DeMarco/DMH-Dual-VCF-Diode-Ladder/README.md

# DMH-Dual-VCF-Diode-Ladder
Stereo version of DMH Diode Ladder VCF
