DeMarco/DMH-Dual-VCF-Diode-Ladder/DMH_Dual_VCF_Diode_Ladder_PCB/DMH_Dual_VCF_Diode_Ladder_PCB.kicad_pcb

## KiCad design DMH_Dual_VCF_Diode_Ladder_PCB/DMH_Dual_VCF_Diode_Ladder_PCB.kicad_pcb (2025-01-10)

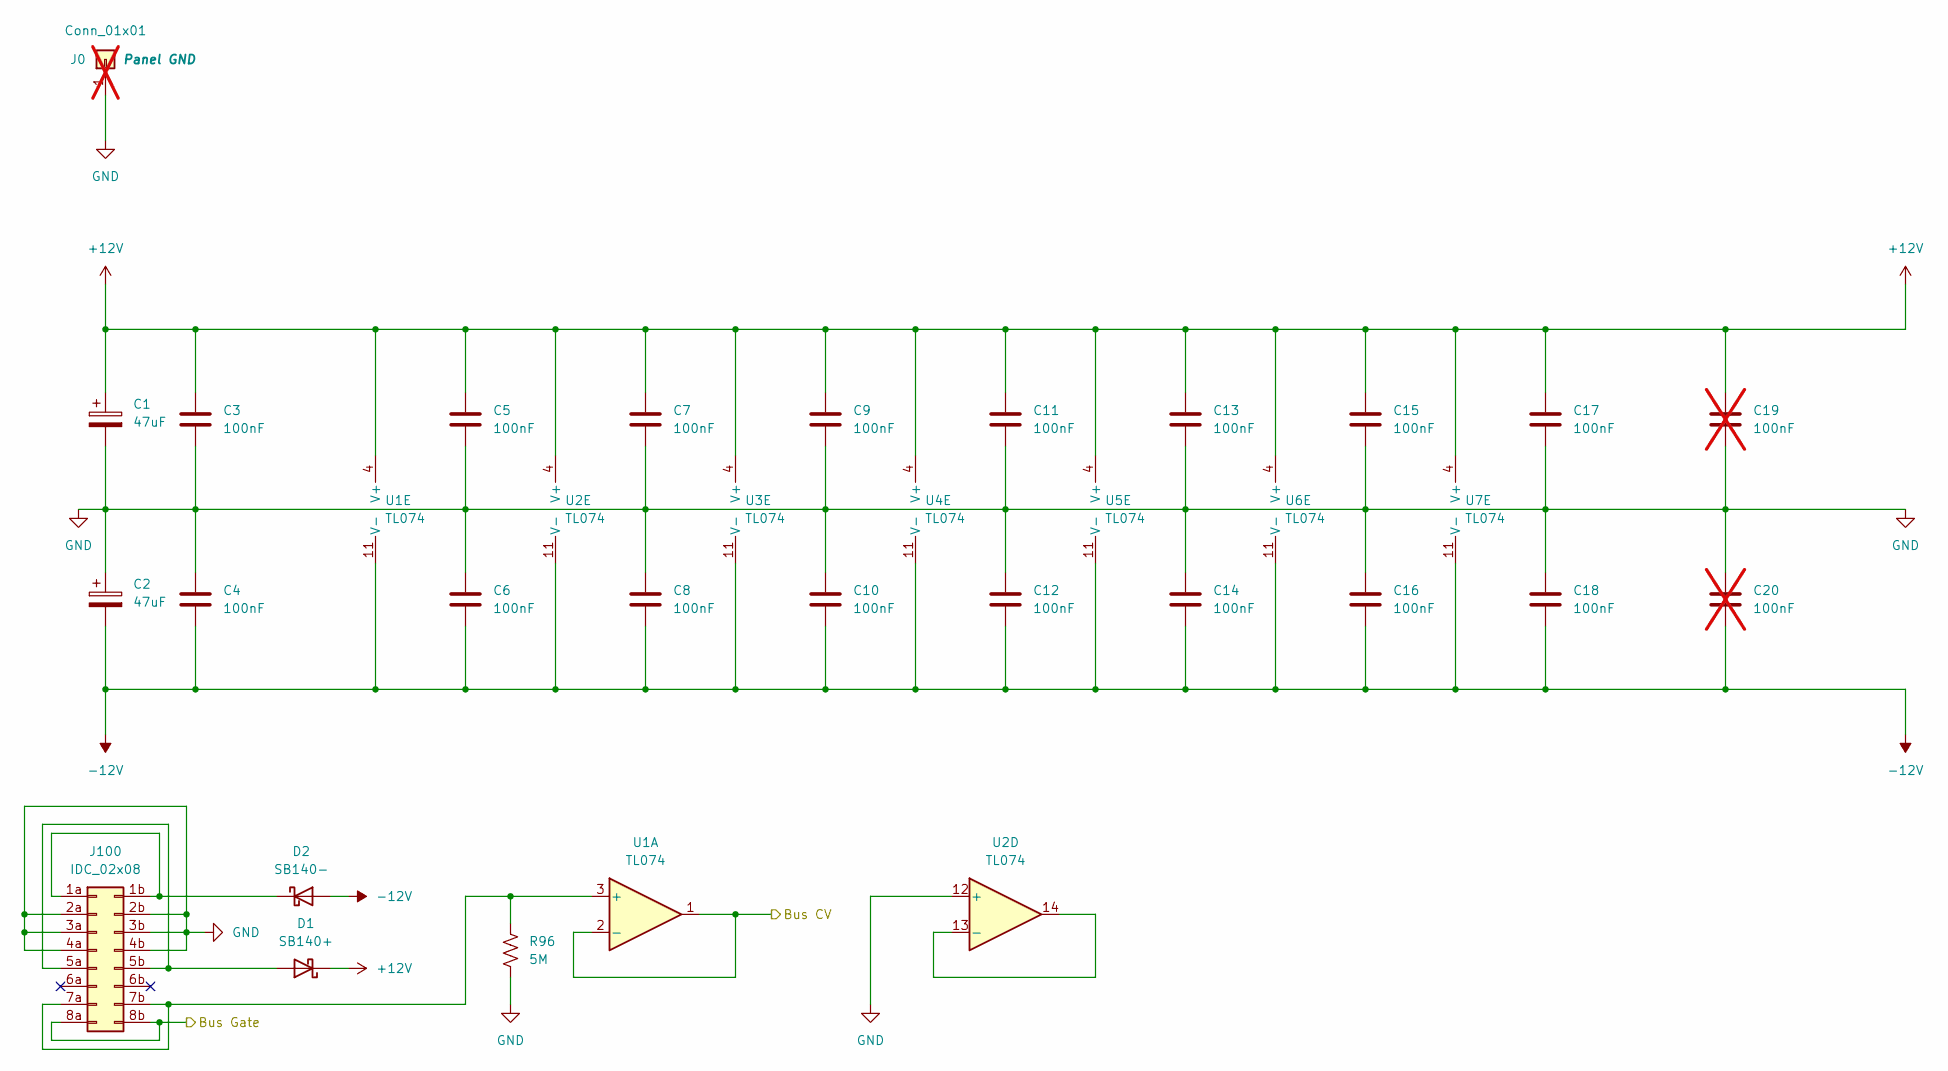
[picture p1: schematic Power.kicad_sch, Power Distribution]

Parts:
C1, C2: 47uF; CP_Radial_D5.0mm_P2.00mm
C3, C4, C5, C6, C7, C8, C9, C10, C11, C12, C13, C14, C15, C16, C17, C18: 100nF; C_Disc_D4.3mm_W1.9mm_P5.00mm
C19, C20: 100nF; C_Disc_D4.3mm_W1.9mm_P5.00mm; not fitted
D1: SB140+; D_DO-41_SOD81_P10.16mm_Horizontal
D2: SB140-; D_DO-41_SOD81_P10.16mm_Horizontal
J0: Conn_01x01; PinHeader_1x01_P2.54mm_Vertical; not fitted
J100: IDC_02x08; IDC-Header_2x08_P2.54mm_Vertical_Eurorack
R96: 5M; R_Axial_DIN0207_L6.3mm_D2.5mm_P7.62mm_Horizontal
U1, U2, U3, U4, U5, U6, U7: TL074; DIP-14_W7.62mm_Socket

Connections:
+12V: C1.1, C3.1, C5.1, C7.1, C9.1, C11.1, C13.1, C15.1, C17.1, C19.1, D1.1 (K), U1.4 (V+), U2.4 (V+), U3.4 (V+), U4.4 (V+), U5.4 (V+), U6.4 (V+), U7.4 (V+); also elsewhere on the board
-12V: C2.2, C4.2, C6.2, C8.2, C10.2, C12.2, C14.2, C16.2, C18.2, C20.2, D2.2 (A), U1.11 (V-), U2.11 (V-), U3.11 (V-), U4.11 (V-), U5.11 (V-), U6.11 (V-), U7.11 (V-); also elsewhere on the board
/CV Processing/Bus CV A Input: U1.1, U1.2 (-); also elsewhere on the board
/Power/Bus Gate: J100.8a, J100.8b
GND: C1.2, C2.1, C3.2, C4.1, C5.2, C6.1, C7.2, C8.1, C9.2, C10.1, C11.2, C12.1, C13.2, C14.1, C15.2, C16.1, C17.2, C18.1, C19.2, C20.1, J0.1, J100.2a, J100.2b, J100.3a, J100.3b, J100.4a, J100.4b, R96.2, U2.12 (+); also elsewhere on the board
unnamed: D1.2 (A), J100.5a, J100.5b
unnamed: D2.1 (K), J100.1a, J100.1b
unnamed: J100.7a, J100.7b, R96.1, U1.3 (+)
unnamed: U2.13 (-), U2.14

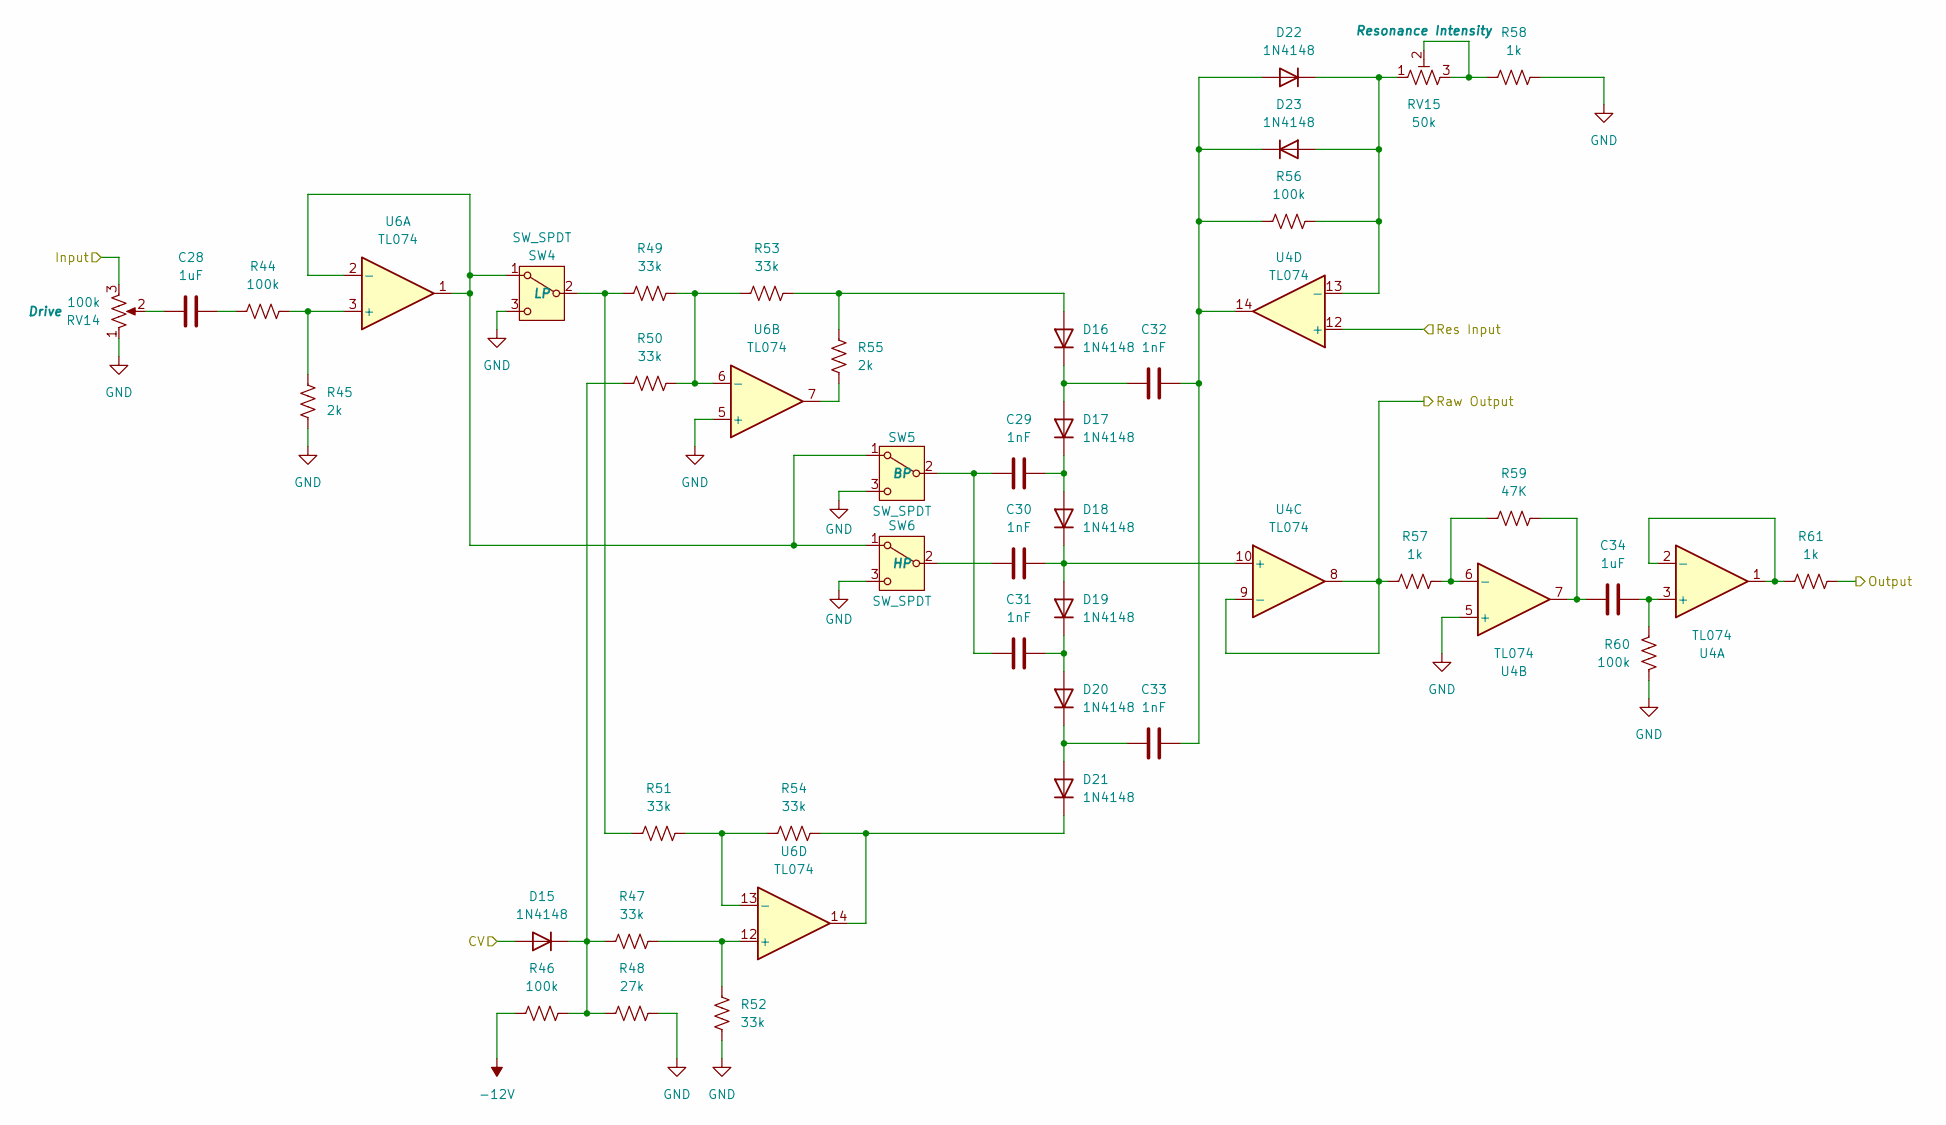
[picture p2: schematic Core_Circuit_B.kicad_sch]

Parts:
C28, C34: 1uF; C_Disc_D4.3mm_W1.9mm_P5.00mm
C29, C30, C31, C32, C33: 1nF; C_Disc_D4.3mm_W1.9mm_P5.00mm
D15, D16, D17, D18, D19, D20, D21, D22, D23: 1N4148; D_DO-35_SOD27_P7.62mm_Horizontal
R44, R46, R56, R60: 100k; R_Axial_DIN0207_L6.3mm_D2.5mm_P7.62mm_Horizontal
R45, R55: 2k; R_Axial_DIN0207_L6.3mm_D2.5mm_P7.62mm_Horizontal
R47, R49, R50, R51, R52, R53, R54: 33k; R_Axial_DIN0207_L6.3mm_D2.5mm_P7.62mm_Horizontal
R48: 27k; R_Axial_DIN0207_L6.3mm_D2.5mm_P7.62mm_Horizontal
R57, R58, R61: 1k; R_Axial_DIN0207_L6.3mm_D2.5mm_P7.62mm_Horizontal
R59: 47K; R_Axial_DIN0207_L6.3mm_D2.5mm_P7.62mm_Horizontal
RV14: 100k; Potentiometer_Alpha_RD901F-40-00D_Single_Vertical
RV15: 50k; Potentiometer_Bourns_3296W_Vertical
SW4, SW5, SW6: SW_SPDT; Toggle_Switch_TE
U4, U6: TL074; DIP-14_W7.62mm_Socket

Connections:
-12V: R46.1; also elsewhere on the board
/CV Processing/Link Switch: D15.2 (A); also elsewhere on the board
/Core Circuit B/Input: RV14.3; also elsewhere on the board
/Core Circuit B/Output: R61.2; also elsewhere on the board
/Core Circuit B/Raw Output: R57.1, U4.8, U4.9 (-); also elsewhere on the board
/Core Circuit B/Res Input: U4.12 (+); also elsewhere on the board
GND: R45.1, R48.2, R52.1, R58.2, R60.1, RV14.1, SW4.3 (C), SW5.3 (C), SW6.3 (C), U4.5 (+), U6.5 (+); also elsewhere on the board
unnamed: C28.1, RV14.2
unnamed: C28.2, R44.1
unnamed: C34.1, R59.2, U4.7
unnamed: D15.1 (K), R46.2, R47.1, R48.1, R50.1
unnamed: D16.2 (A), R53.2, R55.2
unnamed: C32.1, D16.1 (K), D17.2 (A)
unnamed: C29.2, D17.1 (K), D18.2 (A)
unnamed: C30.2, D18.1 (K), D19.2 (A), U4.10 (+)
unnamed: C31.2, D19.1 (K), D20.2 (A)
unnamed: C33.1, D20.1 (K), D21.2 (A)
unnamed: D21.1 (K), R54.2, U6.14
unnamed: C32.2, C33.2, D22.2 (A), D23.1 (K), R56.1, U4.14
unnamed: D22.1 (K), D23.2 (A), R56.2, RV15.1, U4.13 (-)
unnamed: R55.1, U6.7
unnamed: R58.1, RV15.2, RV15.3
unnamed: SW4.1 (A), SW5.1 (A), SW6.1 (A), U6.1, U6.2 (-)
unnamed: R49.1, R51.1, SW4.2 (B)
unnamed: C29.1, C31.1, SW5.2 (B)
unnamed: C30.1, SW6.2 (B)
unnamed: C34.2, R60.2, U4.3 (+)
unnamed: R61.1, U4.1, U4.2 (-)
unnamed: R57.2, R59.1, U4.6 (-)
unnamed: R44.2, R45.2, U6.3 (+)
unnamed: R49.2, R50.2, R53.1, U6.6 (-)
unnamed: R47.2, R52.2, U6.12 (+)
unnamed: R51.2, R54.1, U6.13 (-)

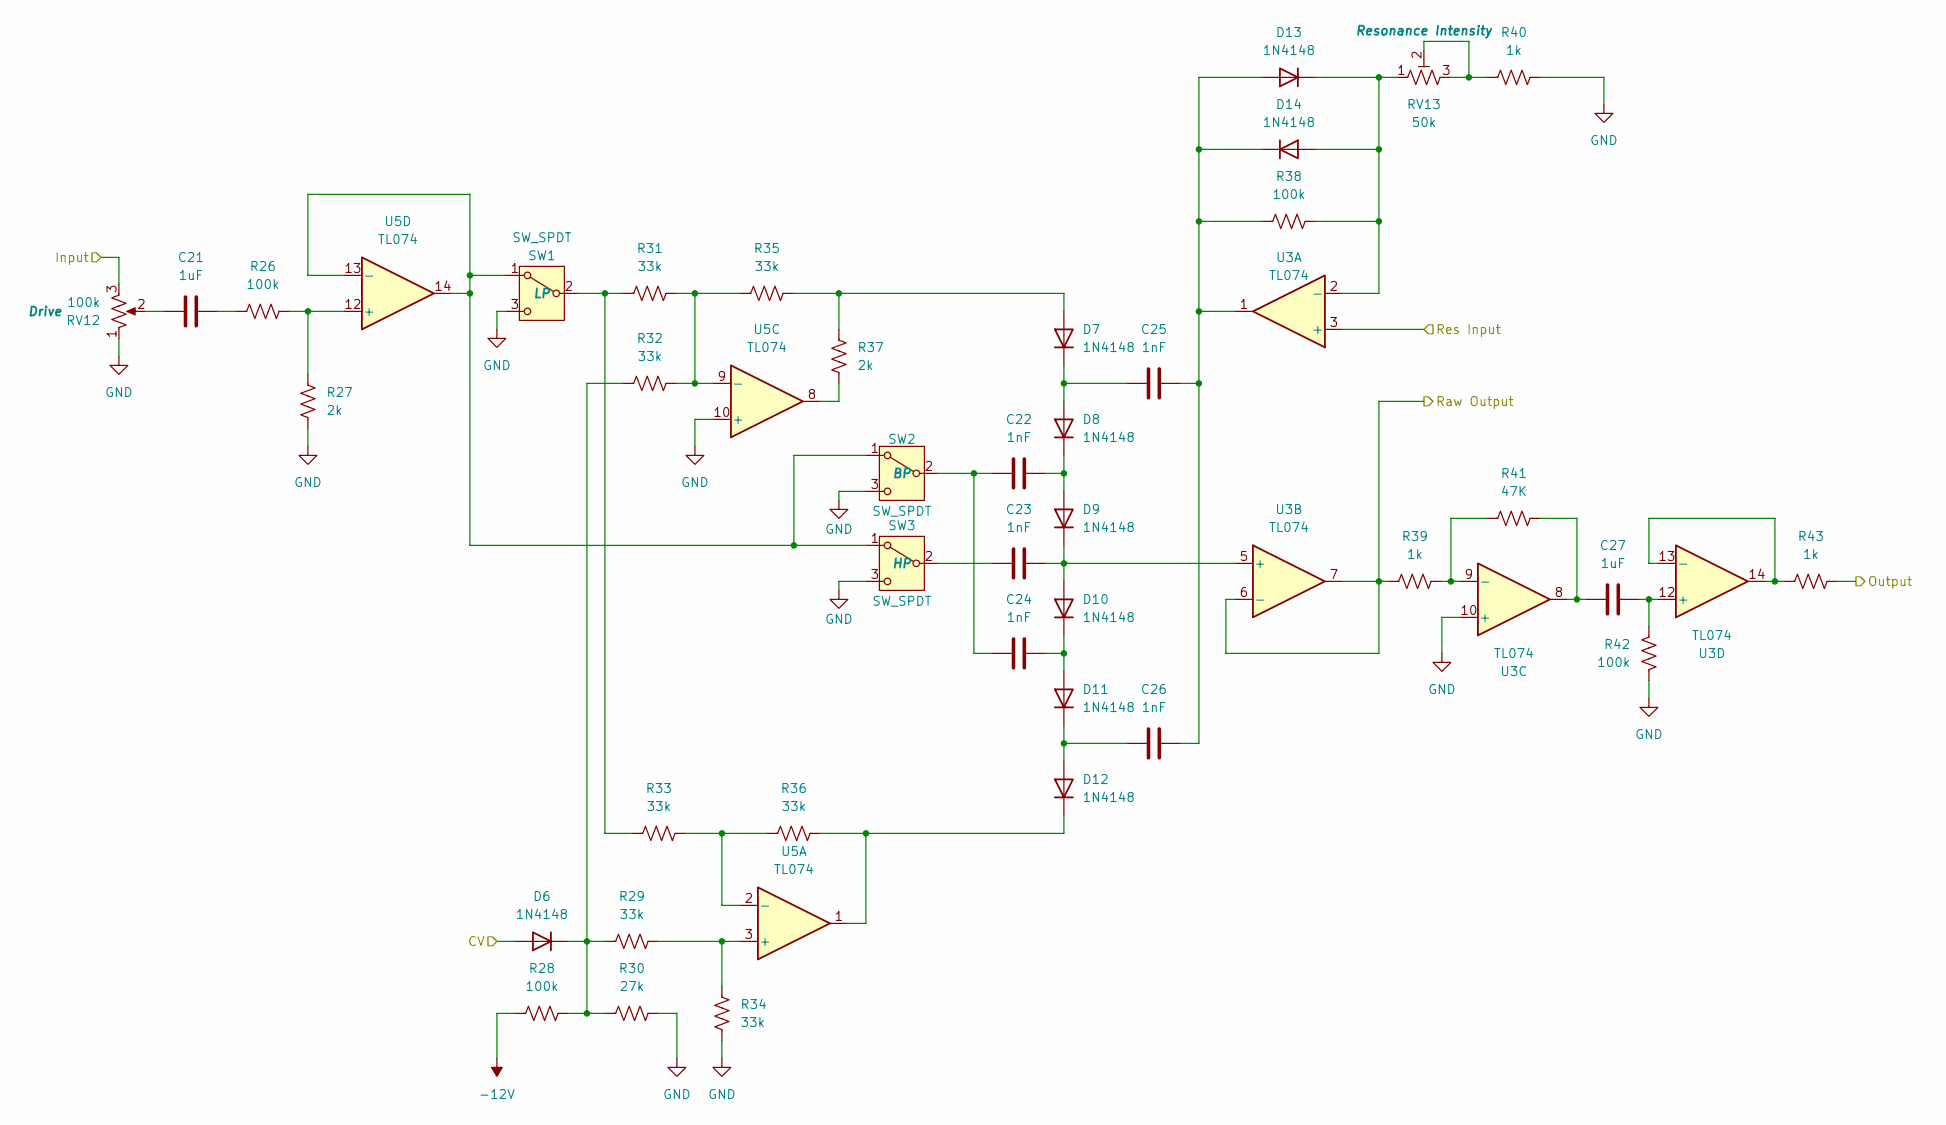
[picture p3: schematic Core_Circuit_A.kicad_sch]

Parts:
C21, C27: 1uF; C_Disc_D4.3mm_W1.9mm_P5.00mm
C22, C23, C24, C25, C26: 1nF; C_Disc_D4.3mm_W1.9mm_P5.00mm
D6, D7, D8, D9, D10, D11, D12, D13, D14: 1N4148; D_DO-35_SOD27_P7.62mm_Horizontal
R26, R28, R38, R42: 100k; R_Axial_DIN0207_L6.3mm_D2.5mm_P7.62mm_Horizontal
R27, R37: 2k; R_Axial_DIN0207_L6.3mm_D2.5mm_P7.62mm_Horizontal
R29, R31, R32, R33, R34, R35, R36: 33k; R_Axial_DIN0207_L6.3mm_D2.5mm_P7.62mm_Horizontal
R30: 27k; R_Axial_DIN0207_L6.3mm_D2.5mm_P7.62mm_Horizontal
R39, R40, R43: 1k; R_Axial_DIN0207_L6.3mm_D2.5mm_P7.62mm_Horizontal
R41: 47K; R_Axial_DIN0207_L6.3mm_D2.5mm_P7.62mm_Horizontal
RV12: 100k; Potentiometer_Alpha_RD901F-40-00D_Single_Vertical
RV13: 50k; Potentiometer_Bourns_3296W_Vertical
SW1, SW2, SW3: SW_SPDT; Toggle_Switch_TE
U3, U5: TL074; DIP-14_W7.62mm_Socket

Connections:
-12V: R28.1; also elsewhere on the board
/CV Processing/CV A: D6.2 (A); also elsewhere on the board
/Core Circuit A/Input: RV12.3; also elsewhere on the board
/Core Circuit A/Output: R43.2; also elsewhere on the board
/Core Circuit A/Raw Output: R39.1, U3.6 (-), U3.7; also elsewhere on the board
/Core Circuit A/Res Input: U3.3 (+); also elsewhere on the board
GND: R27.1, R30.2, R34.1, R40.2, R42.1, RV12.1, SW1.3 (C), SW2.3 (C), SW3.3 (C), U3.10 (+), U5.10 (+); also elsewhere on the board
unnamed: C21.1, RV12.2
unnamed: C21.2, R26.1
unnamed: C27.1, R41.2, U3.8
unnamed: D6.1 (K), R28.2, R29.1, R30.1, R32.1
unnamed: D7.2 (A), R35.2, R37.2
unnamed: C25.1, D7.1 (K), D8.2 (A)
unnamed: C22.2, D8.1 (K), D9.2 (A)
unnamed: C23.2, D9.1 (K), D10.2 (A), U3.5 (+)
unnamed: C24.2, D10.1 (K), D11.2 (A)
unnamed: C26.1, D11.1 (K), D12.2 (A)
unnamed: D12.1 (K), R36.2, U5.1
unnamed: C25.2, C26.2, D13.2 (A), D14.1 (K), R38.1, U3.1
unnamed: D13.1 (K), D14.2 (A), R38.2, RV13.1, U3.2 (-)
unnamed: R37.1, U5.8
unnamed: R40.1, RV13.2, RV13.3
unnamed: SW1.1 (A), SW2.1 (A), SW3.1 (A), U5.13 (-), U5.14
unnamed: R31.1, R33.1, SW1.2 (B)
unnamed: C22.1, C24.1, SW2.2 (B)
unnamed: C23.1, SW3.2 (B)
unnamed: R39.2, R41.1, U3.9 (-)
unnamed: C27.2, R42.2, U3.12 (+)
unnamed: R43.1, U3.13 (-), U3.14
unnamed: R29.2, R34.2, U5.3 (+)
unnamed: R33.2, R36.1, U5.2 (-)
unnamed: R31.2, R32.2, R35.1, U5.9 (-)
unnamed: R26.2, R27.2, U5.12 (+)

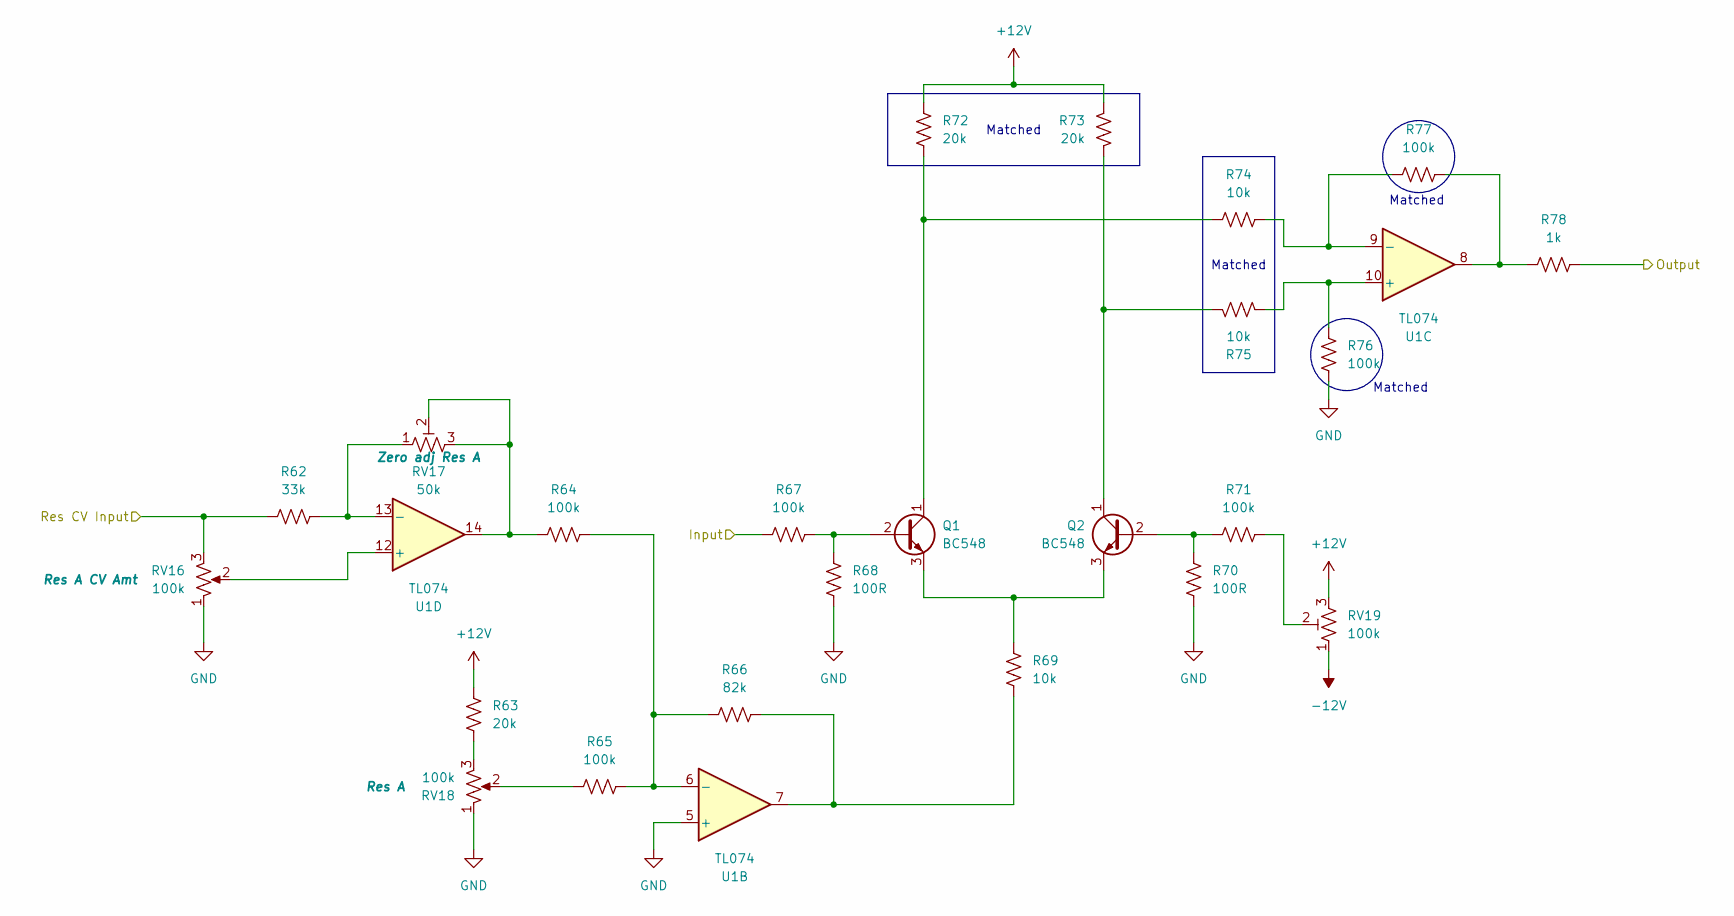
[picture p4: schematic Resonance_A_CV.kicad_sch]

Parts:
Q1, Q2: BC548; TO-92L_Inline_Wide
R62: 33k; R_Axial_DIN0207_L6.3mm_D2.5mm_P7.62mm_Horizontal
R63, R72, R73: 20k; R_Axial_DIN0207_L6.3mm_D2.5mm_P7.62mm_Horizontal
R64, R65, R67, R71, R76, R77: 100k; R_Axial_DIN0207_L6.3mm_D2.5mm_P7.62mm_Horizontal
R66: 82k; R_Axial_DIN0207_L6.3mm_D2.5mm_P7.62mm_Horizontal
R68, R70: 100R; R_Axial_DIN0207_L6.3mm_D2.5mm_P7.62mm_Horizontal
R69, R74, R75: 10k; R_Axial_DIN0207_L6.3mm_D2.5mm_P7.62mm_Horizontal
R78: 1k; R_Axial_DIN0207_L6.3mm_D2.5mm_P7.62mm_Horizontal
RV16: 100k; Potentiometer_TT_P110KH1
RV17: 50k; Potentiometer_Bourns_3296W_Vertical
RV18: 100k; Potentiometer_Alpha_RD901F-40-00D_Single_Vertical
RV19: 100k; Potentiometer_Bourns_3296W_Vertical
U1: TL074; DIP-14_W7.62mm_Socket

Connections:
+12V: R63.2, R72.2, R73.2, RV19.3; also elsewhere on the board
-12V: RV19.1; also elsewhere on the board
/Core Circuit A/Raw Output: R67.2; also elsewhere on the board
/Core Circuit A/Res Input: R78.1; also elsewhere on the board
/Inputs and Outputs A/Res CV Jack: R62.1, RV16.3; also elsewhere on the board
GND: R68.1, R70.1, R76.2, RV16.1, RV18.1, U1.5 (+); also elsewhere on the board
unnamed: Q1.2 (B), R67.1, R68.2
unnamed: Q1.1 (C), R72.1, R74.2
unnamed: Q1.3 (E), Q2.3 (E), R69.2
unnamed: Q2.2 (B), R70.2, R71.2
unnamed: Q2.1 (C), R73.1, R75.2
unnamed: R63.1, RV18.3
unnamed: R64.1, RV17.2, RV17.3, U1.14
unnamed: R65.1, RV18.2
unnamed: R66.2, R69.1, U1.7
unnamed: R71.1, RV19.2
unnamed: R77.1, R78.2, U1.8
unnamed: R64.2, R65.2, R66.1, U1.6 (-)
unnamed: R75.1, R76.1, U1.10 (+)
unnamed: R74.1, R77.2, U1.9 (-)
unnamed: RV16.2, U1.12 (+)
unnamed: R62.2, RV17.1, U1.13 (-)

Notes on the sheet:
Matched

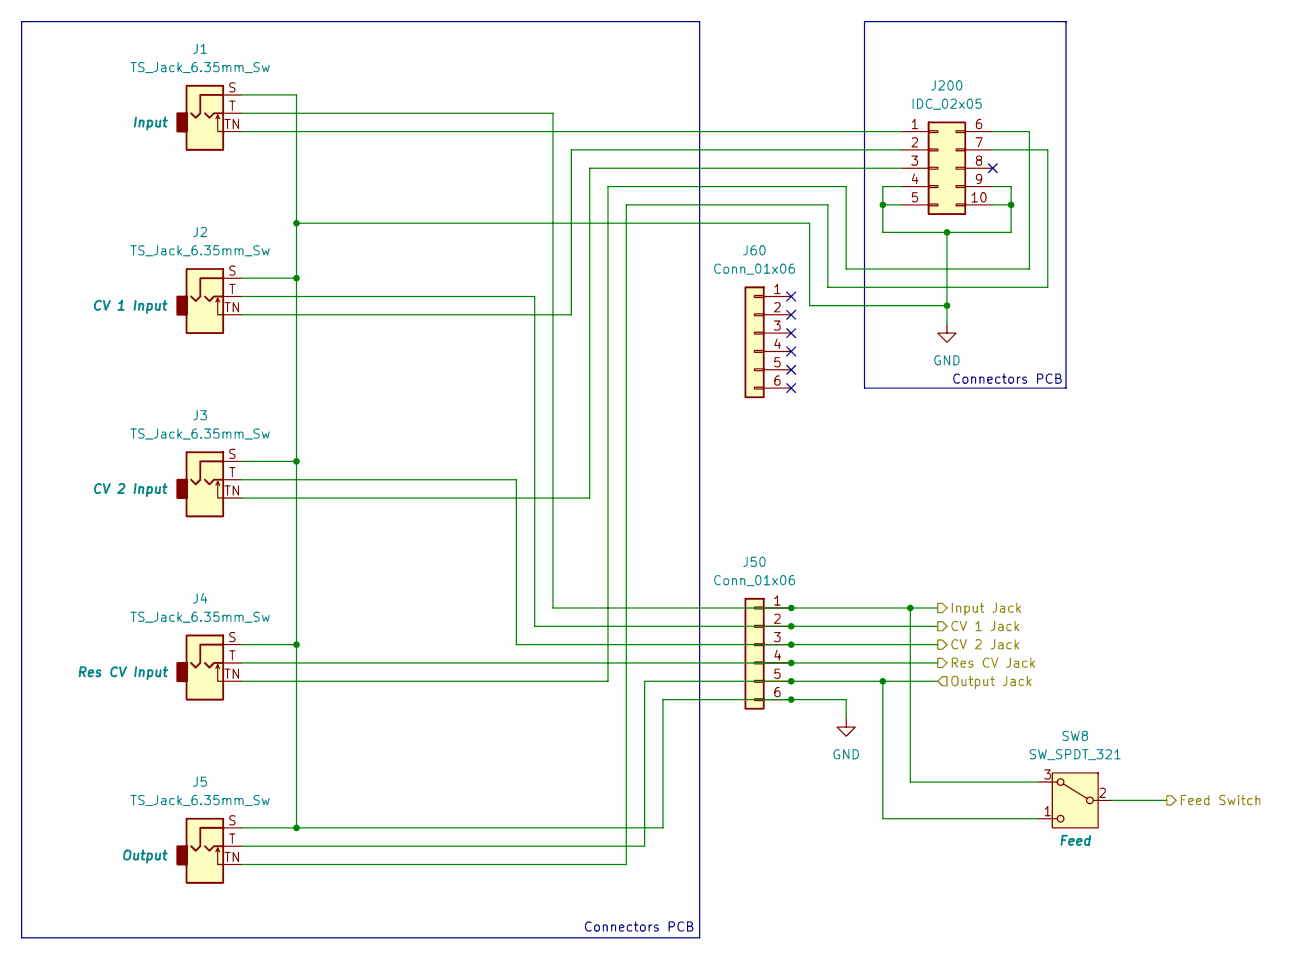
[picture p5: schematic Inputs_and_Outputs_A.kicad_sch]

Parts:
J1, J2, J3, J4, J5: TS_Jack_6.35mm_Sw; CUI_MJ-63052A
J50, J60: Conn_01x06; PinSocket_1x06_P2.54mm_Vertical
J200: IDC_02x05; IDC-Header_2x05_P2.54mm_Vertical_BackBone
SW8: SW_SPDT_321; Toggle_Switch_TE

Connections:
/CV Processing/CV1 A Input: J2.T, J50.2; also elsewhere on the board
/CV Processing/CV2 A Input: J3.T, J50.3; also elsewhere on the board
/Core Circuit A/Input: J1.T, J50.1, SW8.3 (A); also elsewhere on the board
/Core Circuit A/Output: J5.T, J50.5, SW8.1 (C); also elsewhere on the board
/Inputs and Outputs A/Feed Switch: SW8.2 (B); also elsewhere on the board
/Inputs and Outputs A/Res CV Jack: J4.T, J50.4; also elsewhere on the board
GND: J1.S, J2.S, J3.S, J4.S, J5.S, J50.6, J200.4, J200.5, J200.9, J200.10; also elsewhere on the board
unnamed: J1.TN, J200.1
unnamed: J2.TN, J200.2
unnamed: J3.TN, J200.3
unnamed: J4.TN, J200.6
unnamed: J5.TN, J200.7

Notes on the sheet:
Connectors PCB

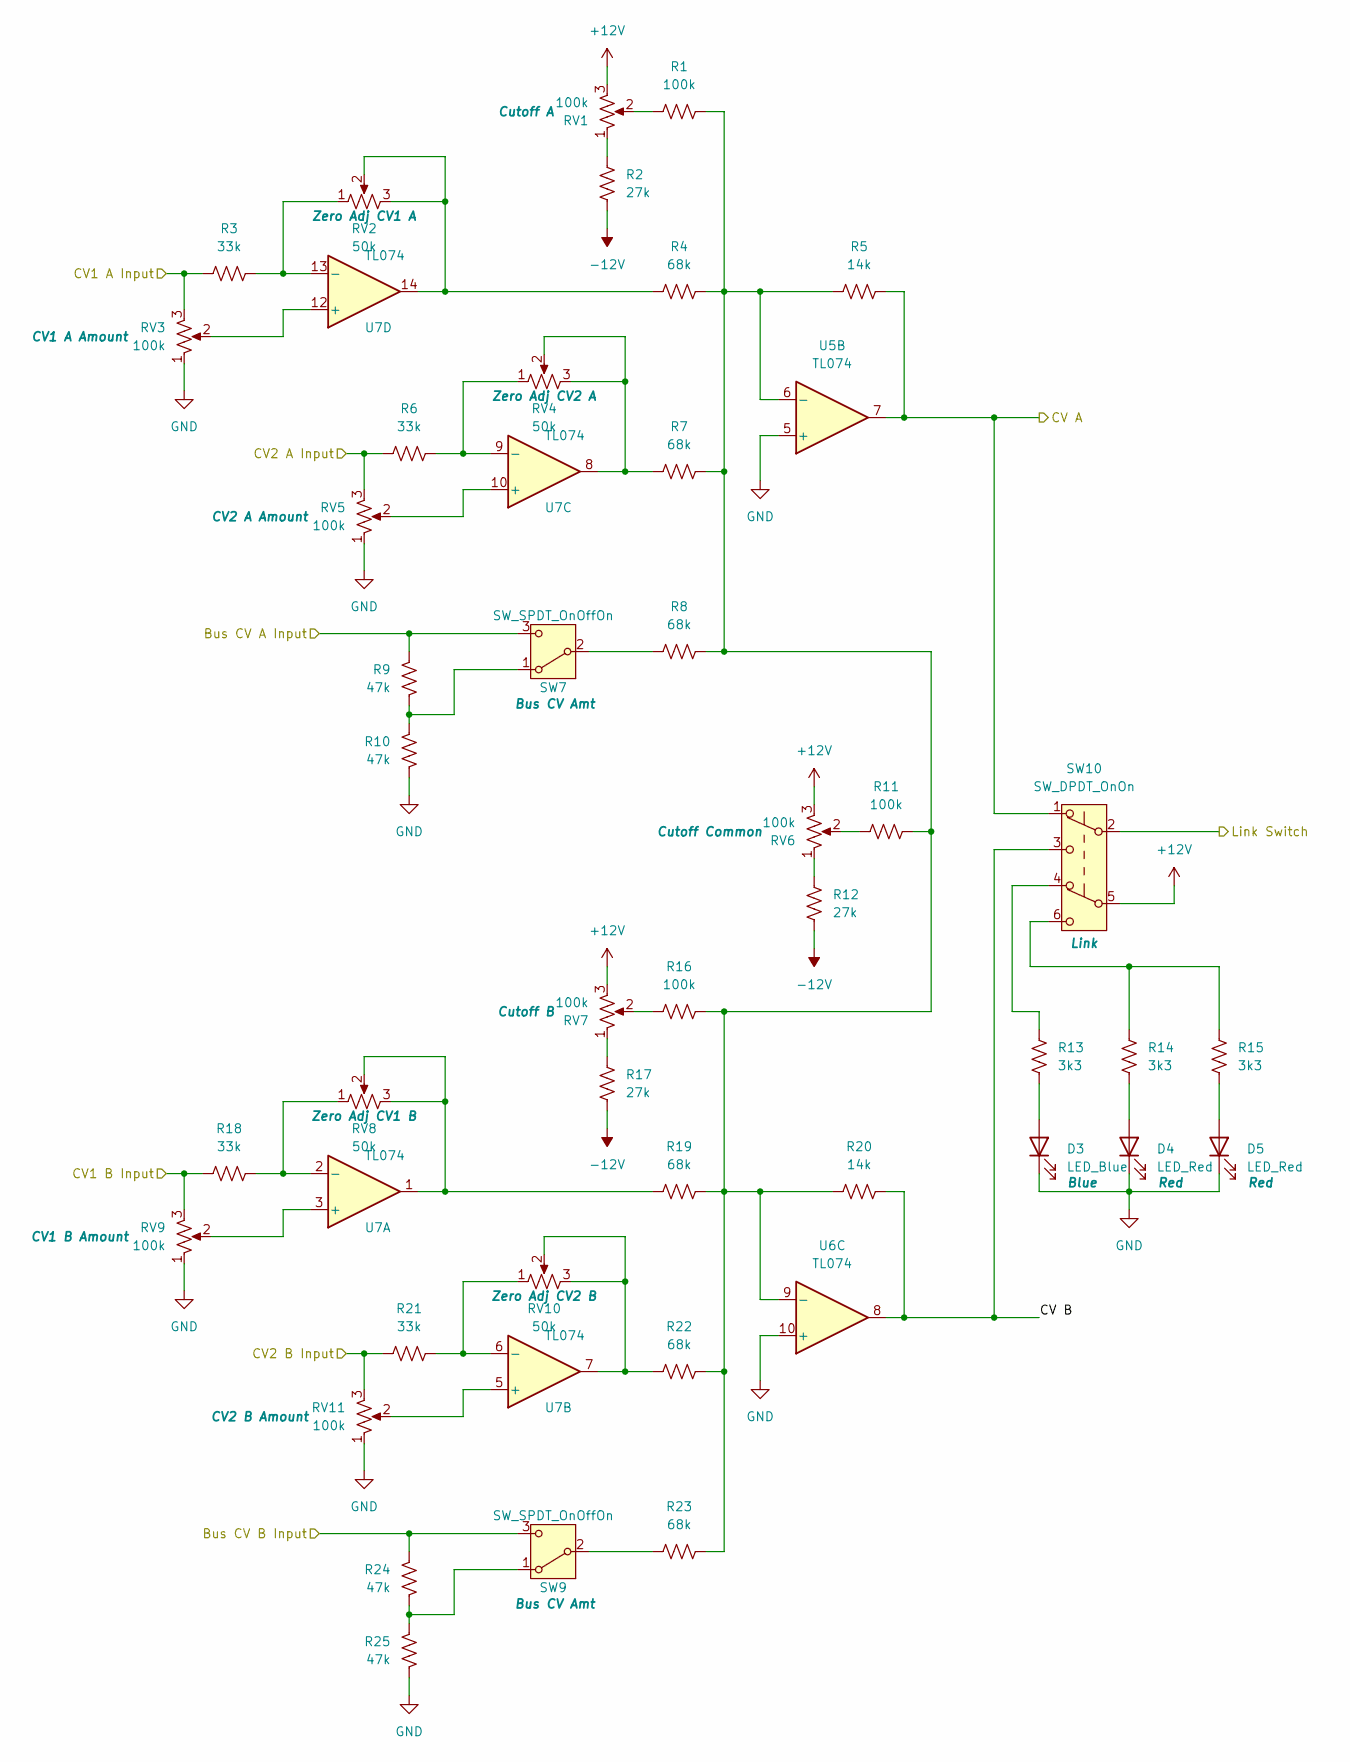
[picture p6: schematic CV_Processing.kicad_sch]

Parts:
D3: LED_Blue; LED_D3.0mm
D4, D5: LED_Red; LED_D3.0mm
R1, R11, R16: 100k; R_Axial_DIN0207_L6.3mm_D2.5mm_P7.62mm_Horizontal
R2, R12, R17: 27k; R_Axial_DIN0207_L6.3mm_D2.5mm_P7.62mm_Horizontal
R3, R6, R18, R21: 33k; R_Axial_DIN0207_L6.3mm_D2.5mm_P7.62mm_Horizontal
R4, R7, R8, R19, R22, R23: 68k; R_Axial_DIN0207_L6.3mm_D2.5mm_P7.62mm_Horizontal
R5, R20: 14k; R_Axial_DIN0207_L6.3mm_D2.5mm_P7.62mm_Horizontal
R9, R10, R24, R25: 47k; R_Axial_DIN0207_L6.3mm_D2.5mm_P7.62mm_Horizontal
R13, R14, R15: 3k3; R_Axial_DIN0207_L6.3mm_D2.5mm_P7.62mm_Horizontal
RV1, RV6, RV7: 100k; Potentiometer_Alpha_RD901F-40-00D_Single_Vertical
RV2, RV4, RV8, RV10: 50k; Potentiometer_Bourns_3296W_Vertical
RV3, RV5, RV9, RV11: 100k; Potentiometer_TT_P110KH1
SW7, SW9: SW_SPDT_OnOffOn; Toggle_Switch_TE
SW10: SW_DPDT_OnOn; Toggle_Switch_2_Poles_TE
U5, U6, U7: TL074; DIP-14_W7.62mm_Socket

Connections:
+12V: RV1.3, RV6.3, RV7.3, SW10.5 (B); also elsewhere on the board
-12V: R2.2, R12.2, R17.2; also elsewhere on the board
/CV Processing/Bus CV A Input: R9.2, R24.2, SW7.3 (C), SW9.3 (C); also elsewhere on the board
/CV Processing/CV1 A Input: R3.1, RV3.3; also elsewhere on the board
/CV Processing/CV1 B Input: R18.1, RV9.3; also elsewhere on the board
/CV Processing/CV2 A Input: R6.1, RV5.3; also elsewhere on the board
/CV Processing/CV2 B Input: R21.1, RV11.3; also elsewhere on the board
/CV Processing/CV A: R5.2, SW10.1 (A), U5.7; also elsewhere on the board
/CV Processing/CV B: R20.2, SW10.3 (C), U6.8
/CV Processing/Link Switch: SW10.2 (B); also elsewhere on the board
GND: D3.1 (K), D4.1 (K), D5.1 (K), R10.1, R25.1, RV3.1, RV5.1, RV9.1, RV11.1, U5.5 (+), U6.10 (+); also elsewhere on the board
unnamed: D3.2 (A), R13.2
unnamed: D4.2 (A), R14.2
unnamed: D5.2 (A), R15.2
unnamed: R1.1, RV1.2
unnamed: R2.1, RV1.1
unnamed: R4.1, RV2.2, RV2.3, U7.14
unnamed: R7.1, RV4.2, RV4.3, U7.8
unnamed: R11.1, RV6.2
unnamed: R12.1, RV6.1
unnamed: R13.1, SW10.4 (A)
unnamed: R14.1, R15.1, SW10.6 (C)
unnamed: R16.1, RV7.2
unnamed: R17.1, RV7.1
unnamed: R19.1, RV8.2, RV8.3, U7.1
unnamed: R22.1, RV10.2, RV10.3, U7.7
unnamed: R9.1, R10.2, SW7.1 (A)
unnamed: R8.2, SW7.2 (B)
unnamed: R24.1, R25.2, SW9.1 (A)
unnamed: R23.2, SW9.2 (B)
unnamed: R1.2, R4.2, R5.1, R7.2, R8.1, R11.2, R16.2, R19.2, R20.1, R22.2, R23.1, U5.6 (-), U6.9 (-)
unnamed: RV9.2, U7.3 (+)
unnamed: R18.2, RV8.1, U7.2 (-)
unnamed: RV11.2, U7.5 (+)
unnamed: R21.2, RV10.1, U7.6 (-)
unnamed: RV5.2, U7.10 (+)
unnamed: R6.2, RV4.1, U7.9 (-)
unnamed: RV3.2, U7.12 (+)
unnamed: R3.2, RV2.1, U7.13 (-)

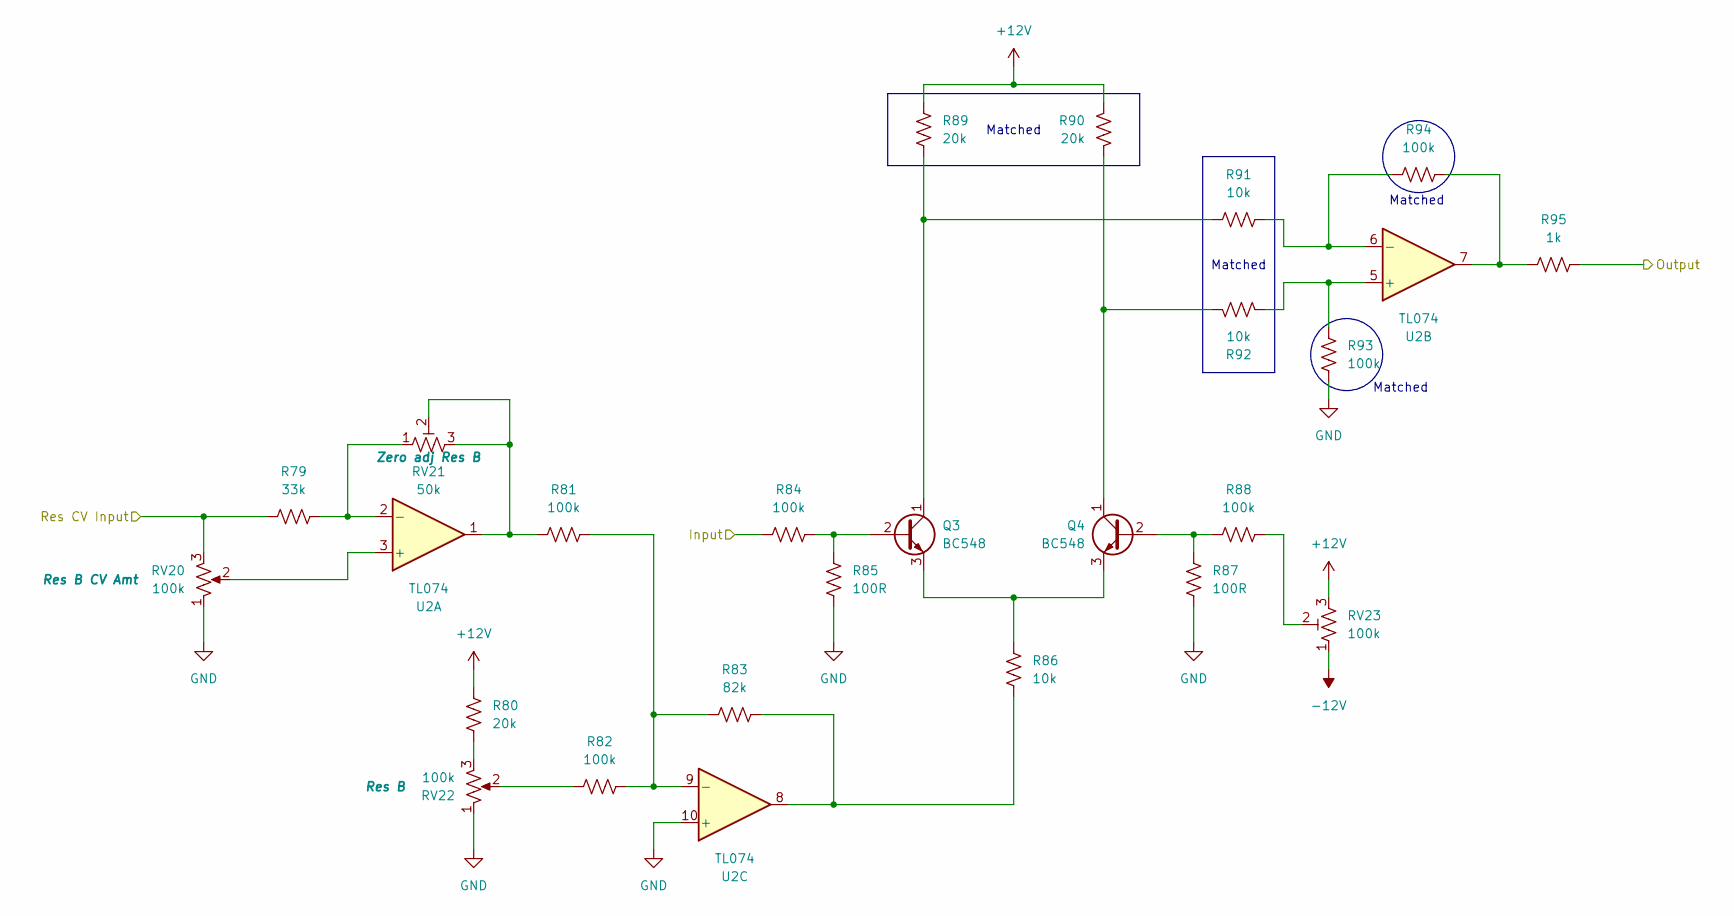
[picture p7: schematic Resonance_B_CV.kicad_sch]

Parts:
Q3, Q4: BC548; TO-92L_Inline_Wide
R79: 33k; R_Axial_DIN0207_L6.3mm_D2.5mm_P7.62mm_Horizontal
R80, R89, R90: 20k; R_Axial_DIN0207_L6.3mm_D2.5mm_P7.62mm_Horizontal
R81, R82, R84, R88, R93, R94: 100k; R_Axial_DIN0207_L6.3mm_D2.5mm_P7.62mm_Horizontal
R83: 82k; R_Axial_DIN0207_L6.3mm_D2.5mm_P7.62mm_Horizontal
R85, R87: 100R; R_Axial_DIN0207_L6.3mm_D2.5mm_P7.62mm_Horizontal
R86, R91, R92: 10k; R_Axial_DIN0207_L6.3mm_D2.5mm_P7.62mm_Horizontal
R95: 1k; R_Axial_DIN0207_L6.3mm_D2.5mm_P7.62mm_Horizontal
RV20: 100k; Potentiometer_TT_P110KH1
RV21: 50k; Potentiometer_Bourns_3296W_Vertical
RV22: 100k; Potentiometer_Alpha_RD901F-40-00D_Single_Vertical
RV23: 100k; Potentiometer_Bourns_3296W_Vertical
U2: TL074; DIP-14_W7.62mm_Socket

Connections:
+12V: R80.2, R89.2, R90.2, RV23.3; also elsewhere on the board
-12V: RV23.1; also elsewhere on the board
/Core Circuit B/Raw Output: R84.2; also elsewhere on the board
/Core Circuit B/Res Input: R95.1; also elsewhere on the board
/Inputs and Outputs B/Res CV Jack: R79.1, RV20.3; also elsewhere on the board
GND: R85.1, R87.1, R93.2, RV20.1, RV22.1, U2.10 (+); also elsewhere on the board
unnamed: Q3.2 (B), R84.1, R85.2
unnamed: Q3.1 (C), R89.1, R91.2
unnamed: Q3.3 (E), Q4.3 (E), R86.2
unnamed: Q4.2 (B), R87.2, R88.2
unnamed: Q4.1 (C), R90.1, R92.2
unnamed: R80.1, RV22.3
unnamed: R81.1, RV21.2, RV21.3, U2.1
unnamed: R82.1, RV22.2
unnamed: R83.2, R86.1, U2.8
unnamed: R88.1, RV23.2
unnamed: R94.1, R95.2, U2.7
unnamed: RV20.2, U2.3 (+)
unnamed: R79.2, RV21.1, U2.2 (-)
unnamed: R92.1, R93.1, U2.5 (+)
unnamed: R91.1, R94.2, U2.6 (-)
unnamed: R81.2, R82.2, R83.1, U2.9 (-)

Notes on the sheet:
Matched
