DeMarco/DMH-Dual-VCF-Diode-Ladder/DMH_Dual_VCF_Diode_Ladder_PCB/DMH_Dual_VCF_Diode_Ladder_PCB.kicad_pcb

## KiCad design DMH_Dual_VCF_Diode_Ladder_PCB/DMH_Dual_VCF_Diode_Ladder_PCB.kicad_pcb (continued)

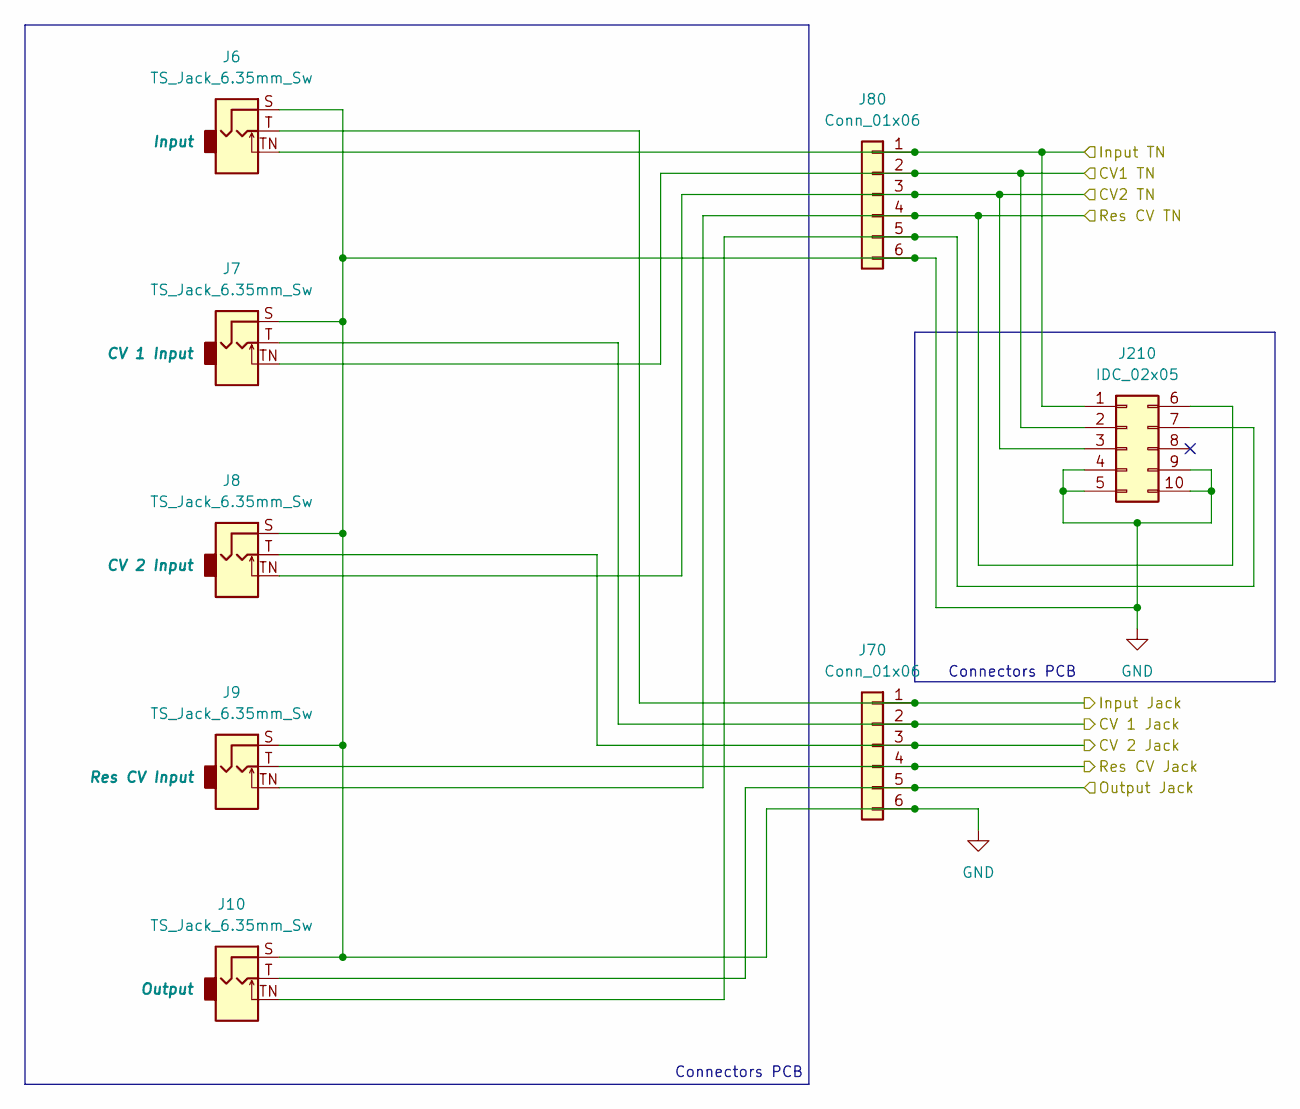
[picture p8: schematic Inputs_and_Outputs_B.kicad_sch]

Parts:
J6, J7, J8, J9, J10: TS_Jack_6.35mm_Sw; CUI_MJ-63052A
J70, J80: Conn_01x06; PinSocket_1x06_P2.54mm_Vertical
J210: IDC_02x05; IDC-Header_2x05_P2.54mm_Vertical_BackBone

Connections:
/CV Processing/CV1 A Input: J7.TN, J80.2, J210.2; also elsewhere on the board
/CV Processing/CV1 B Input: J7.T, J70.2; also elsewhere on the board
/CV Processing/CV2 A Input: J8.TN, J80.3, J210.3; also elsewhere on the board
/CV Processing/CV2 B Input: J8.T, J70.3; also elsewhere on the board
/Core Circuit B/Input: J6.T, J70.1; also elsewhere on the board
/Core Circuit B/Output: J10.T, J70.5; also elsewhere on the board
/Inputs and Outputs A/Feed Switch: J6.TN, J80.1, J210.1; also elsewhere on the board
/Inputs and Outputs A/Res CV Jack: J9.TN, J80.4, J210.6; also elsewhere on the board
/Inputs and Outputs B/Res CV Jack: J9.T, J70.4; also elsewhere on the board
GND: J6.S, J7.S, J8.S, J9.S, J10.S, J70.6, J80.6, J210.4, J210.5, J210.9, J210.10; also elsewhere on the board
unnamed: J10.TN, J80.5, J210.7

Notes on the sheet:
Connectors PCB

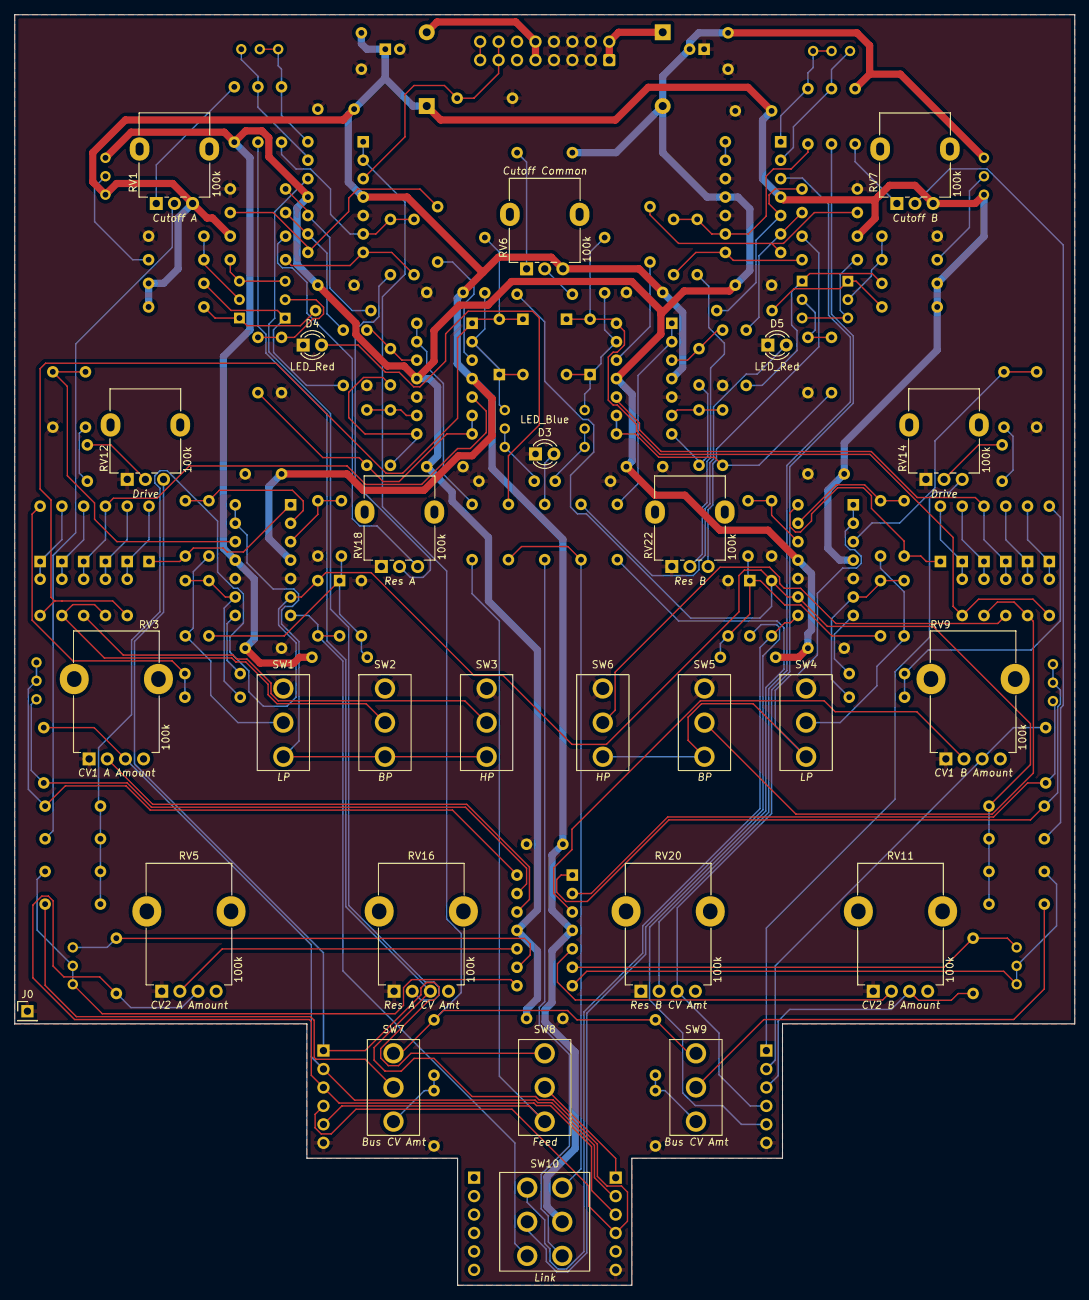
[picture p9: board DMH_Dual_VCF_Diode_Ladder_PCB.kicad_pcb from above]

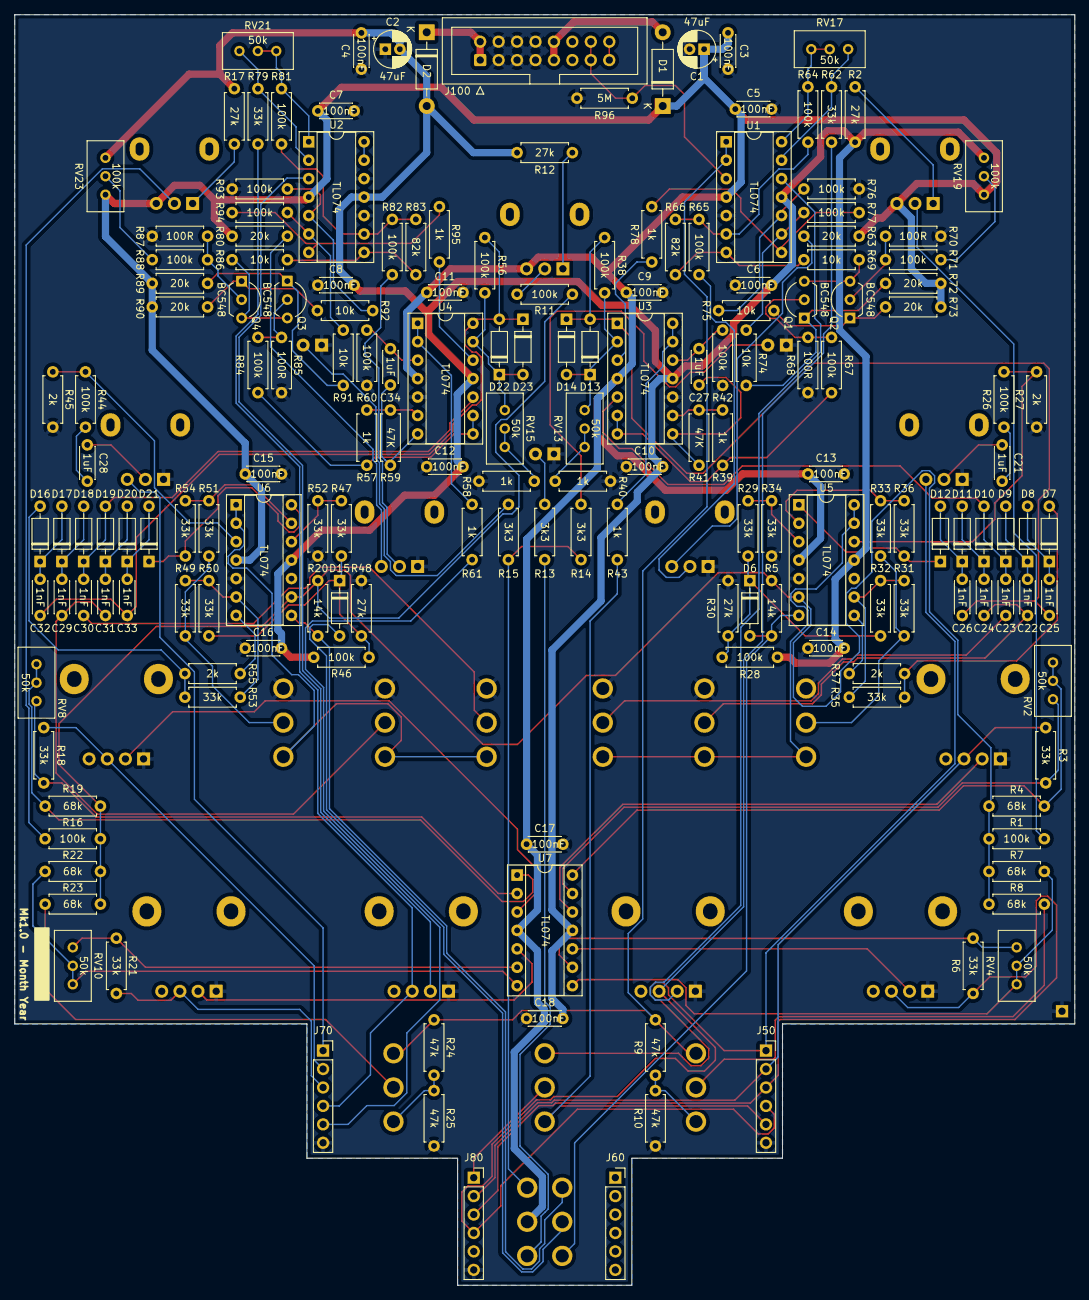
[picture p10: board DMH_Dual_VCF_Diode_Ladder_PCB.kicad_pcb from below]

Board: 2 copper layers, 146.0 x 175.0 mm, 201 parts (174 on the bottom side), 139 nets.
