DeMarco/DMH-Dual-VCF-Diode-Ladder/DMH_Dual_VCF_Diode_Ladder_PCB_Conn/DMH_Dual_VCF_Diode_Ladder_PCB_Conn.kicad_pcb

## KiCad design DMH_Dual_VCF_Diode_Ladder_PCB_Conn/DMH_Dual_VCF_Diode_Ladder_PCB_Conn.kicad_pcb (2024-11-21)

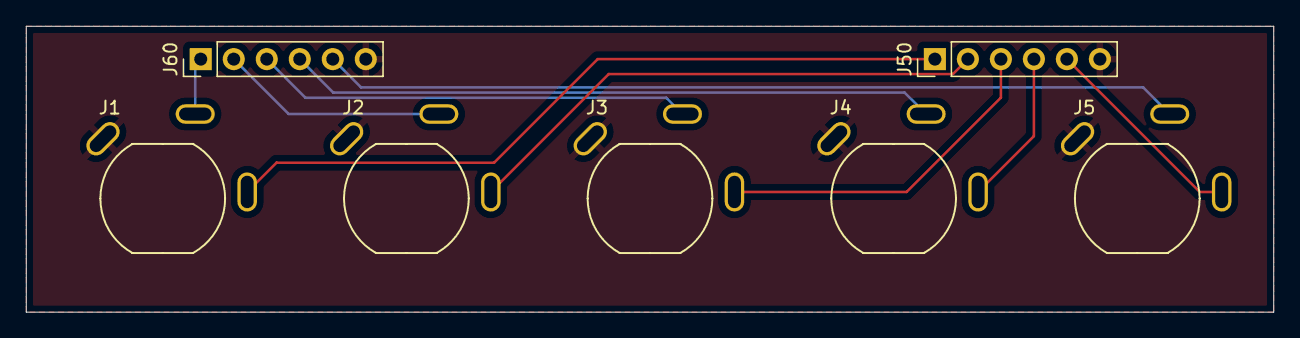
[picture p11: board DMH_Dual_VCF_Diode_Ladder_PCB_Conn.kicad_pcb from above]

Board: 2 copper layers, 96.0 x 22.0 mm, 7 parts (0 on the bottom side), 11 nets.

Parts:
J1, J2, J3, J4, J5: TS_Jack_6.35mm_Sw; CUI_MJ-63052A
J50, J60: Conn_01x06; PinHeader_1x06_P2.54mm_Vertical

Connections:
/Core Circuit/(Bus) CV2 Input: J3.T, J50.3
/Core Circuit/CV1 Input: J2.T, J50.2
/Core Circuit/CV3 Input: J4.T, J50.4
/Core Circuit/Input: J1.T, J50.1
/Core Circuit/Output: J5.T, J50.5
GND: J1.S, J2.S, J3.S, J4.S, J5.S, J50.6, J60.6
unnamed: J1.TN, J60.1
unnamed: J2.TN, J60.2
unnamed: J3.TN, J60.3
unnamed: J4.TN, J60.4
unnamed: J5.TN, J60.5
