DeMarco/DMH-Dual-VCF-Diode-Ladder/(commit log)

2024-11-09 Copied Panel project from mono VCF repo
    [DMH_Dual_VCF_Diode_Ladder_PANEL.kicad_pcb, DMH_Dual_VCF_Diode_Ladder_PANEL.kicad_sch]
2024-11-09 Finished panel
    [DMH_Dual_VCF_Diode_Ladder_PANEL.kicad_pcb, DMH_Dual_VCF_Diode_Ladder_PANEL.kicad_sch]
2024-11-10 Changed line art
    [DMH_Dual_VCF_Diode_Ladder_PANEL.kicad_pcb]
2024-11-18 Changed from unlink to split
    [DMH_Dual_VCF_Diode_Ladder_PANEL.kicad_pcb]
2024-11-18 Added central cutoff knob
    [DMH_Dual_VCF_Diode_Ladder_PANEL.kicad_pcb, DMH_Dual_VCF_Diode_Ladder_PANEL.kicad_sch]
2024-11-21 Copied PCB and Connectors projects
    [Core_Circuit.kicad_sch, DMH_Dual_VCF_Diode_Ladder_PCB.kicad_pcb, DMH_Dual_VCF_Diode_Ladder_PCB.kicad_sch, DMH_Dual_VCF_Diode_Ladder_PCB_Conn.kicad_pcb, DMH_Dual_VCF_Diode_Ladder_PCB_Conn.kicad_sch, Inputs_and_Outputs.kicad_sch, Power.kicad_sch]
2024-11-21 Changed features on panel
    [DMH_Dual_VCF_Diode_Ladder_PANEL.kicad_pcb, DMH_Dual_VCF_Diode_Ladder_PANEL.kicad_sch, DMH_Dual_VCF_Diode_Ladder_PCB.kicad_sch]
2024-11-24 Reorganized panel
    ... and added Feed switch.
    [DMH_Dual_VCF_Diode_Ladder_PANEL.kicad_pcb, DMH_Dual_VCF_Diode_Ladder_PANEL.kicad_sch]
2024-11-24 Started circuit schematic
    [Bridge.kicad_sch, Core_Circuit_A.kicad_sch, DMH_Dual_VCF_Diode_Ladder_PCB.kicad_sch, Inputs_and_Outputs_A.kicad_sch, Inputs_and_Outputs_B.kicad_sch]
2024-11-27 Updated attenuverter pot cutouts to P110KH1
    [DMH_Dual_VCF_Diode_Ladder_PANEL.kicad_pcb]
2024-11-30 Starting Res CV design
    [Core_Circuit_A.kicad_sch, DMH_Dual_VCF_Diode_Ladder_PCB.kicad_sch, Resonance_CV.kicad_sch]
2024-12-08 Generated BoM
    [Bridge.kicad_sch, Core_Circuit_A.kicad_sch, DMH_Dual_VCF_Diode_Ladder_PANEL.kicad_sch]
2025-01-01 Concluded core and resonance circuits design
    [Core_Circuit_B.kicad_sch, DMH_Dual_VCF_Diode_Ladder_PANEL.kicad_pcb, DMH_Dual_VCF_Diode_Ladder_PCB.kicad_sch, Inputs_and_Outputs_A.kicad_sch, Inputs_and_Outputs_B.kicad_sch, Resonance_A_CV.kicad_sch, Resonance_B_CV.kicad_sch]
2025-01-01 Changed Bus CV switch silkscreen
    [DMH_Dual_VCF_Diode_Ladder_PANEL.kicad_pcb, DMH_Dual_VCF_Diode_Ladder_PANEL.kicad_sch]
2025-01-01 Schematic design in progress
    [Core_Circuit_A.kicad_sch, Core_Circuit_B.kicad_sch, Power.kicad_sch]
2025-01-01 Added Bus CV buffering
    [CV_Processing.kicad_sch, DMH_Dual_VCF_Diode_Ladder_PCB.kicad_sch, Power.kicad_sch]
2025-01-03 Made CV processing page
    [CV_Processing.kicad_sch, Core_Circuit_A.kicad_sch, Core_Circuit_B.kicad_sch, DMH_Dual_VCF_Diode_Ladder_PCB.kicad_sch]
2025-01-03 Finished designing circuit
    [CV_Processing.kicad_sch, Core_Circuit_B.kicad_sch, DMH_Dual_VCF_Diode_Ladder_PCB.kicad_sch, Inputs_and_Outputs_A.kicad_sch]
2025-01-03 Reannotated whole schematic
    OpAmp annotation is still tentative.
    [CV_Processing.kicad_sch, Core_Circuit_A.kicad_sch, Core_Circuit_B.kicad_sch, DMH_Dual_VCF_Diode_Ladder_PCB.kicad_sch, Inputs_and_Outputs_A.kicad_sch, Inputs_and_Outputs_B.kicad_sch, Power.kicad_sch, Resonance_A_CV.kicad_sch]
2025-01-03 Reannotated OpAmps and cleared errors
    [CV_Processing.kicad_sch, Core_Circuit_A.kicad_sch, Core_Circuit_B.kicad_sch, Power.kicad_sch, Resonance_A_CV.kicad_sch, Resonance_B_CV.kicad_sch]
2025-01-03 Updated switches symbols and fps
    [CV_Processing.kicad_sch, Core_Circuit_A.kicad_sch, Core_Circuit_B.kicad_sch, DMH_Dual_VCF_Diode_Ladder_PANEL.kicad_pcb, DMH_Dual_VCF_Diode_Ladder_PANEL.kicad_sch, Inputs_and_Outputs_A.kicad_sch, Power.kicad_sch]
2025-01-03 Placed panel hole references on Main PCB
    [DMH_Dual_VCF_Diode_Ladder_PCB.kicad_pcb]
2025-01-03 Placed location dependent components on PCB
    [CV_Processing.kicad_sch, DMH_Dual_VCF_Diode_Ladder_PCB.kicad_pcb, Resonance_A_CV.kicad_sch, Resonance_B_CV.kicad_sch]
2025-01-04 Placed ICs and prepared passives
    [DMH_Dual_VCF_Diode_Ladder_PCB.kicad_pcb, Inputs_and_Outputs_A.kicad_sch, Inputs_and_Outputs_B.kicad_sch]
2025-01-04 Re-annotated OpAmps as per PCB layout
    [CV_Processing.kicad_sch, Core_Circuit_A.kicad_sch, Core_Circuit_B.kicad_sch, DMH_Dual_VCF_Diode_Ladder_PCB.kicad_pcb, Power.kicad_sch, Resonance_A_CV.kicad_sch, Resonance_B_CV.kicad_sch]
2025-01-05 Component placement in progress
    [DMH_Dual_VCF_Diode_Ladder_PCB.kicad_pcb]
2025-01-07 Component placement done
    [DMH_Dual_VCF_Diode_Ladder_PCB.kicad_pcb, Resonance_A_CV.kicad_sch, Resonance_B_CV.kicad_sch]
2025-01-08 Corrections before routing in progress
    [DMH_Dual_VCF_Diode_Ladder_PCB.kicad_pcb]
2025-01-09 Routing ongoing
    [DMH_Dual_VCF_Diode_Ladder_PCB.kicad_pcb, Power.kicad_sch]
2025-01-09 Routing in progress
    [DMH_Dual_VCF_Diode_Ladder_PCB.kicad_pcb]
2025-01-10 Finished routing
    [Core_Circuit_A.kicad_sch, Core_Circuit_B.kicad_sch, DMH_Dual_VCF_Diode_Ladder_PCB.kicad_pcb, Inputs_and_Outputs_A.kicad_sch]
